Cyb3rn0id/ENROV/README.md

# enrov
 Esp-Now Remote Operated Vehicle
