Cyb3rn0id/ENROV/docs/schematics/rev001/sch_remote_rev001.png

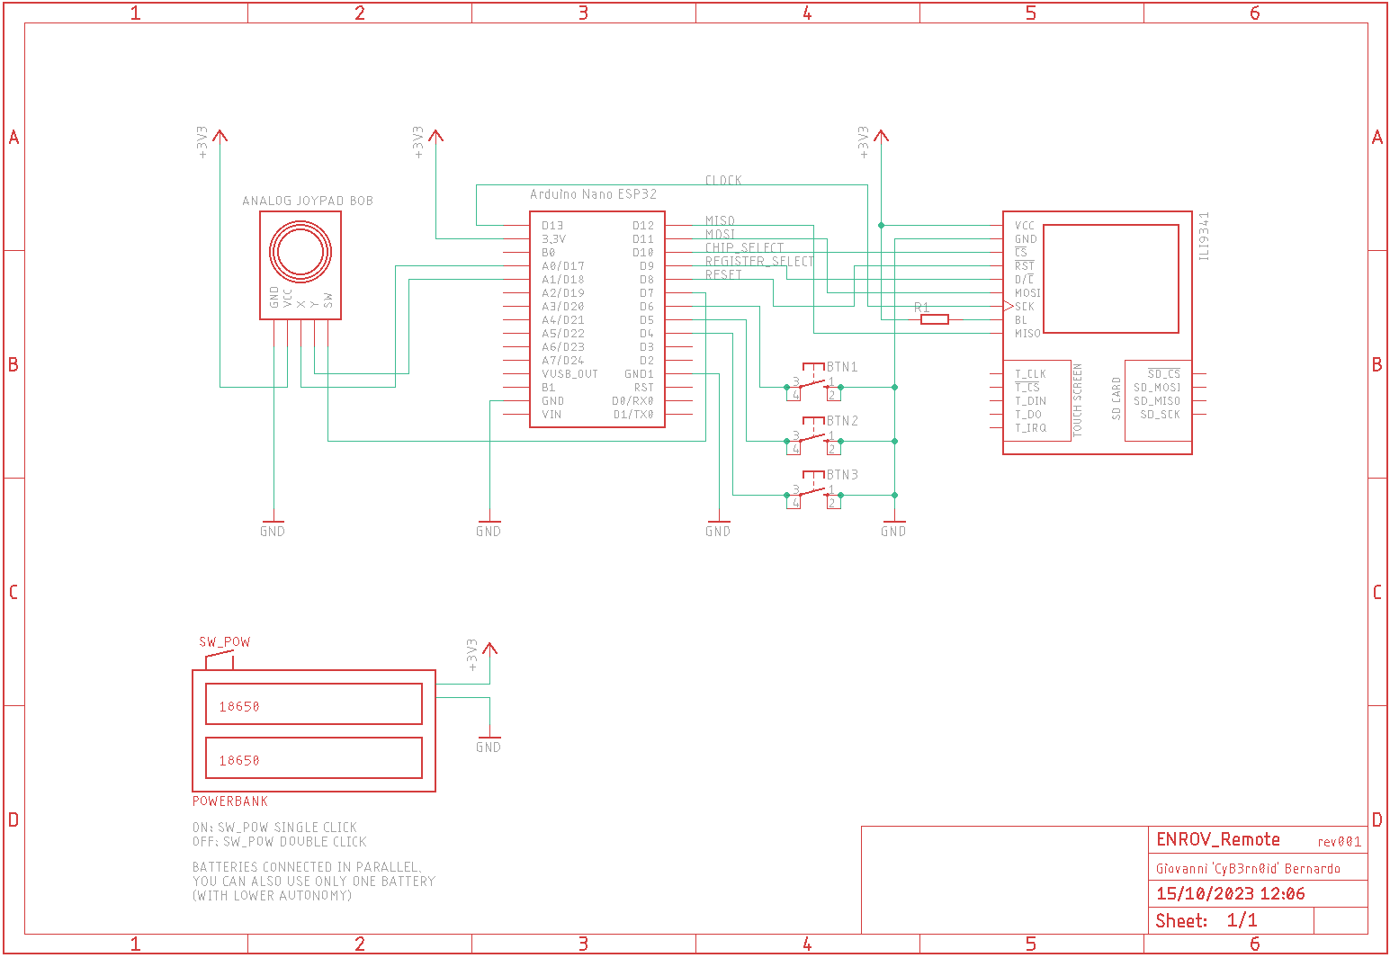
docs/schematics/rev001/sch_remote_rev001.png
