Cyb3rn0id/ENROV/arduino/ENROV_remote/bitmaps.h

// ENROV - ESP NOW Remote Operated Vehicle by @cyb3rn0id
// Bitmaps used for fancy stuff on the display

// Arduino logo, 100x47
const unsigned char bmp_ArduinoLogo[] PROGMEM = {
	0x00, 0x00, 0x03, 0xf0, 0x00, 0x00, 0x00, 0x00, 0x00, 0xfe, 0x00, 0x00, 0x00, 0x00, 0x00, 0x7f, 
	0xff, 0x80, 0x00, 0x00, 0x00, 0x0f, 0xff, 0xe0, 0x00, 0x00, 0x00, 0x03, 0xff, 0xff, 0xe0, 0x00, 
	0x00, 0x00, 0x7f, 0xff, 0xfc, 0x00, 0x00, 0x00, 0x0f, 0xff, 0xff, 0xfc, 0x00, 0x00, 0x01, 0xff, 
	0xff, 0xff, 0x00, 0x00, 0x00, 0x1f, 0xff, 0xff, 0xfe, 0x00, 0x00, 0x07, 0xff, 0xff, 0xff, 0xc0, 
	0x00, 0x00, 0x7f, 0xff, 0xff, 0xff, 0x80, 0x00, 0x0f, 0xff, 0xff, 0xff, 0xe0, 0x00, 0x00, 0xff, 
	0xff, 0xff, 0xff, 0xc0, 0x00, 0x3f, 0xff, 0xff, 0xff, 0xf0, 0x00, 0x01, 0xff, 0xff, 0xff, 0xff, 
	0xe0, 0x00, 0x7f, 0xff, 0xff, 0xff, 0xf8, 0x00, 0x03, 0xff, 0xf8, 0x07, 0xff, 0xf0, 0x00, 0xff, 
	0xff, 0x01, 0xff, 0xfc, 0x00, 0x07, 0xff, 0xc0, 0x00, 0xff, 0xf8, 0x01, 0xff, 0xf0, 0x00, 0x3f, 
	0xfe, 0x00, 0x07, 0xff, 0x00, 0x00, 0x3f, 0xfc, 0x03, 0xff, 0xc0, 0x00, 0x0f, 0xff, 0x00, 0x0f, 
	0xfc, 0x00, 0x00, 0x0f, 0xfe, 0x03, 0xff, 0x80, 0x00, 0x03, 0xff, 0x00, 0x1f, 0xf8, 0x00, 0x00, 
	0x07, 0xff, 0x07, 0xfe, 0x00, 0x00, 0x01, 0xff, 0x80, 0x1f, 0xf0, 0x00, 0x00, 0x03, 0xff, 0x0f, 
	0xfc, 0x00, 0x00, 0x00, 0xff, 0xc0, 0x3f, 0xe0, 0x00, 0x00, 0x01, 0xff, 0x9f, 0xf8, 0x00, 0x00, 
	0x00, 0x7f, 0xc0, 0x3f, 0xe0, 0x00, 0x00, 0x00, 0xff, 0xff, 0xf0, 0x00, 0x00, 0x00, 0x3f, 0xc0, 
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
	0x00, 0x1e, 0x3f, 0xc0, 0x1f, 0xe0, 0x00, 0x00, 0x00, 0x0f, 0xf0, 0x7f, 0x80, 0x00, 0x00, 0x00, 
	0x03, 0xfc, 0xfe, 0x00, 0x00, 0x00, 0x00, 0x00, 0xfe, 0xf8, 0x00, 0x00, 0x00, 0x00, 0x00, 0x3e, 
	0xe0, 0x00, 0x00, 0x00, 0x00, 0x00, 0x0e, 0x00, 0x00, 0x00, 0x00, 0x00, 0x00, 0x00};
